ESToo-zx/STM32-HC08-Watch/firmware/HAL/Core/Src/main.c

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
/* Includes ------------------------------------------------------------------*/
#include "main.h"

ADC_HandleTypeDef hadc1;

RTC_HandleTypeDef hrtc;

TIM_HandleTypeDef htim2;

UART_HandleTypeDef huart1;

/* USER CODE BEGIN PV */
uint8_t RxByte;        // Rx接收到的数据
extern RTC_TimeTypeDef sTime;
extern RTC_DateTypeDef sDate;

/* USER CODE END PV */

void SystemClock_Config(void);
static void MX_GPIO_Init(void);
static void MX_ADC1_Init(void);
static void MX_RTC_Init(void);
static void MX_TIM2_Init(void);
static void MX_USART1_UART_Init(void);
/* USER CODE BEGIN 0 */

uint8_t free_sec; //???????

/* USER CODE END 0 */

/**
  * @brief  The application entry point.
  * @retval int
  */
int main(void)
{

  /* USER CODE BEGIN 1 */
	
	int DisplayPage;
	extern int press_time;
	extern uint8_t Key_Num;
	//uint8_t RxByte;        // ?????Rx???????????
	
  /* USER CODE END 1 */

  /* MCU Configuration--------------------------------------------------------*/

  /* Reset of all peripherals, Initializes the Flash interface and the Systick. */
  HAL_Init();

  /* Configure the system clock */
  SystemClock_Config();

  /* Initialize all configured peripherals */
  MX_GPIO_Init();
  MX_ADC1_Init();
  MX_RTC_Init();
  MX_TIM2_Init();
  MX_USART1_UART_Init();
  /* USER CODE BEGIN 2 */
	
	
	
	/*OLED初始化*/
	OLED_Init();
	OLED_Clear();
	
	HAL_TIM_Base_Start_IT(&htim2);    //使能TIM2
	HAL_UART_Receive_IT(&huart1, &RxByte, sizeof(RxByte));//使能USART1
	

  /* USER CODE END 2 */

  /* Infinite loop */
  /* USER CODE BEGIN WHILE */
  while (1)
  {
		
		DisplayPage=Interaction_MainPage();
		switch(DisplayPage) 
			{
				case 1:      Enter_Menu();    							break;
				case 2:			Interaction_SettingPage();    	break;
				default: 																		break;
			}
			
		
    /* USER CODE END WHILE */

    /* USER CODE BEGIN 3 */
  }
  /* USER CODE END 3 */
}

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
/* USER CODE BEGIN 4 */

void isEnter_StandByMode(void)
{
  
	static uint16_t count = 0;
	
  if (++count >= 1000) {                 //TIM2频率为u1000Hz(1ms), 需要分频为1s
      count = 0;
		if (++free_sec >= 120) //120秒为操作进入待机模式
		{
			free_sec = 0;
			OLED_Clear();
			OLED_Update();
//			// 待机前调用
//			RTC_DateTypeDef sDate;
//			RTC_TimeTypeDef sTime;
//			HAL_RTC_GetDate(&hrtc, &sDate, RTC_FORMAT_BIN);
//			HAL_RTC_GetTime(&hrtc, &sTime, RTC_FORMAT_BIN);
//			HAL_RTCEx_BKUPWrite(&hrtc, RTC_BKP_DR2, (sDate.Year << 8) | sDate.Month);  // 年月
//			// 把 Year 移到高 8 位；把 Month 放到低 8 位；数据为16位，高16位再次补零然后存入32位
//			HAL_RTCEx_BKUPWrite(&hrtc, RTC_BKP_DR3, (sDate.Date << 8) | sTime.Hours);  // 日时
//			HAL_RTCEx_BKUPWrite(&hrtc, RTC_BKP_DR4, (sTime.Minutes << 8) | sTime.Seconds); // 分秒
			HAL_PWR_EnableWakeUpPin(PWR_WAKEUP_PIN1);//使能PA0为WAKEUP引脚
			HAL_PWR_EnterSTANDBYMode();	//进入StandBy模式
			//SystemClock_Config();										//重启时钟，这里不需要
		}
	}
}

/* USER CODE END 4 */
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
