ESToo-zx/STM32-HC08-Watch/firmware/HAL/Core/Inc/main.h

#define Pin_KEY3_Pin GPIO_PIN_0
#define Pin_KEY3_GPIO_Port GPIOA
#define Pin_KEY2_Pin GPIO_PIN_6
#define Pin_KEY2_GPIO_Port GPIOA
#define Pin_KEY1_Pin GPIO_PIN_1
#define Pin_KEY1_GPIO_Port GPIOB
#define Pin_SI2C_SCL_Pin GPIO_PIN_10
#define Pin_SI2C_SCL_GPIO_Port GPIOB
#define Pin_SI2C_SDA_Pin GPIO_PIN_11
#define Pin_SI2C_SDA_GPIO_Port GPIOB
#define BAT_ADC_EN_Pin GPIO_PIN_11
#define BAT_ADC_EN_GPIO_Port GPIOA
#define CTL_Pin GPIO_PIN_12
#define CTL_GPIO_Port GPIOA
