ESToo-zx/STM32-HC08-Watch/firmware/StdPeriph/Hardware/OLED_Data.c

#include "OLED_Data.h"

/**
  * 数据存储格式：
  * 纵向8点，高位在下，先从左到右，再从上到下
  * 每一个Bit对应一个像素点
  * 
  *      B0 B0                  B0 B0
  *      B1 B1                  B1 B1
  *      B2 B2                  B2 B2
  *      B3 B3  ------------->  B3 B3 --
  *      B4 B4                  B4 B4  |
  *      B5 B5                  B5 B5  |
  *      B6 B6                  B6 B6  |
  *      B7 B7                  B7 B7  |
  *                                    |
  *  -----------------------------------
  *  |   
  *  |   B0 B0                  B0 B0
  *  |   B1 B1                  B1 B1
  *  |   B2 B2                  B2 B2
  *  --> B3 B3  ------------->  B3 B3
  *      B4 B4                  B4 B4
  *      B5 B5                  B5 B5
  *      B6 B6                  B6 B6
  *      B7 B7                  B7 B7
  * 
  */

/*ASCII字模数据*********************/

/*宽8像素，高16像素*/
const uint8_t OLED_F8x16[][16] =
{
	0x00,0x00,0x00,0x00,0x00,0x00,0x00,0x00,
	0x00,0x00,0x00,0x00,0x00,0x00,0x00,0x00,//   0
	0x00,0x00,0x00,0xF8,0x00,0x00,0x00,0x00,
	0x00,0x00,0x00,0x33,0x30,0x00,0x00,0x00,// ! 1
	0x00,0x16,0x0E,0x00,0x16,0x0E,0x00,0x00,
	0x00,0x00,0x00,0x00,0x00,0x00,0x00,0x00,// " 2
	0x40,0xC0,0x78,0x40,0xC0,0x78,0x40,0x00,
	0x04,0x3F,0x04,0x04,0x3F,0x04,0x04,0x00,// # 3
	0x00,0x70,0x88,0xFC,0x08,0x30,0x00,0x00,
	0x00,0x18,0x20,0xFF,0x21,0x1E,0x00,0x00,// $ 4
	0xF0,0x08,0xF0,0x00,0xE0,0x18,0x00,0x00,
	0x00,0x21,0x1C,0x03,0x1E,0x21,0x1E,0x00,// % 5
	0x00,0xF0,0x08,0x88,0x70,0x00,0x00,0x00,
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
};

const uint8_t Player_Start[] = {
	//开始图标（两竖线）
	0x00,0x00,0xFC,0xFC,0xFC,0xFC,0x00,0x00,0x00,0xFC,0xFC,0xFC,0xFC,0x00,0x00,0x00,
0x00,0x00,0x1F,0x1F,0x1F,0x1F,0x00,0x00,0x00,0x1F,0x1F,0x1F,0x1F,0x00,0x00,0x00,
};

const uint8_t Player_Stop[] = {
	//停止图标（triangle）
	0x00,0x00,0x00,0x00,0x00,0xFE,0xFC,0xF8,0xF0,0xE0,0xC0,0x80,0x00,0x00,0x00,0x00,
0x00,0x00,0x00,0x00,0x00,0xFF,0x7F,0x3F,0x1F,0x0F,0x07,0x03,0x01,0x00,0x00,0x00,
};

const uint8_t Player_Restart[] = {
	//圆圈返回图标
	0x00,0x00,0xF8,0xFC,0x0C,0x0C,0x0C,0x0C,0x0C,0x0C,0x0C,0x1C,0x78,0x70,0x00,0x00,
0x00,0x00,0x1F,0x3F,0x30,0x30,0x30,0x30,0x30,0x30,0x36,0x3E,0x1E,0x1E,0x00,0x00,
};

const uint8_t Setting[] = {
	//设置-齿轮
	0x00,0x80,0x9C,0xFC,0xF8,0xF0,0x78,0x3E,0x3E,0x78,0xFC,0xFC,0xCC,0x80,0x80,0x00,
0x00,0x01,0x31,0x3B,0x1F,0x1F,0x1E,0x7C,0x7C,0x1E,0x0F,0x1F,0x3F,0x39,0x01,0x00,
};


/*按照上面的格式，在这个位置加入新的图像数据*/
//...

/*********************图像数据*/


/*****************江协科技|版权所有****************/
/*****************jiangxiekeji.com*****************/
