ESToo-zx/STM32-HC08-Watch/firmware/StdPeriph/Hardware/LED.c

#include "stm32f10x.h"                  // Device header

void LED_Init(void)
{
	RCC_APB2PeriphClockCmd(RCC_APB2Periph_GPIOA, ENABLE);
	
	GPIO_InitTypeDef GPIO_InitStructure;
	GPIO_InitStructure.GPIO_Mode = GPIO_Mode_Out_PP;
	GPIO_InitStructure.GPIO_Pin = GPIO_Pin_12|GPIO_Pin_11;
	GPIO_InitStructure.GPIO_Speed = GPIO_Speed_50MHz;
	GPIO_Init(GPIOA, &GPIO_InitStructure);
	
	GPIO_ResetBits(GPIOA, GPIO_Pin_11);//BAT_ADC_EN
	GPIO_SetBits(GPIOA, GPIO_Pin_12); //CTL
}
