ESToo-zx/STM32-HC08-Watch/(notices)

Notices in the files:
firmware/HAL/Core/Src/main.c:
Copyright (c) 2026 STMicroelectronics.
All rights reserved.
This software is licensed under terms that can be found in the LICENSE file
